nygma2004/Wifi_LokRemote/img/wired.jpg.jpg

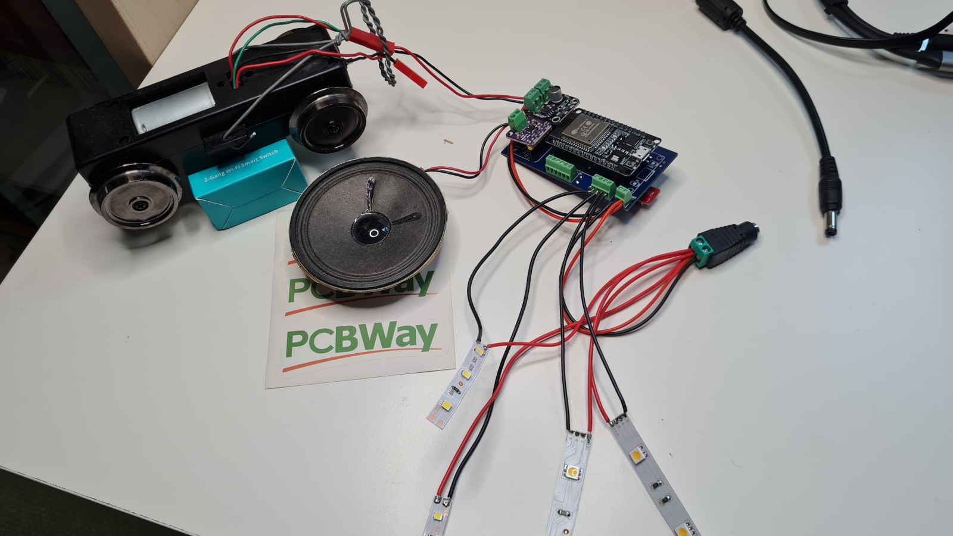
img/wired.jpg.jpg
