nygma2004/Wifi_LokRemote/img/with_phone_02.jpg

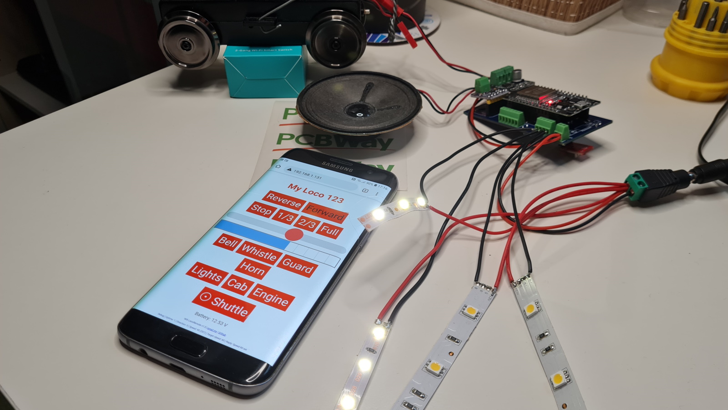
img/with_phone_02.jpg
