nygma2004/Wifi_LokRemote/pcb/Schematic_LocoRemote_v1_0.pdf

## PWM Motor Driver Board

## 5V power supply

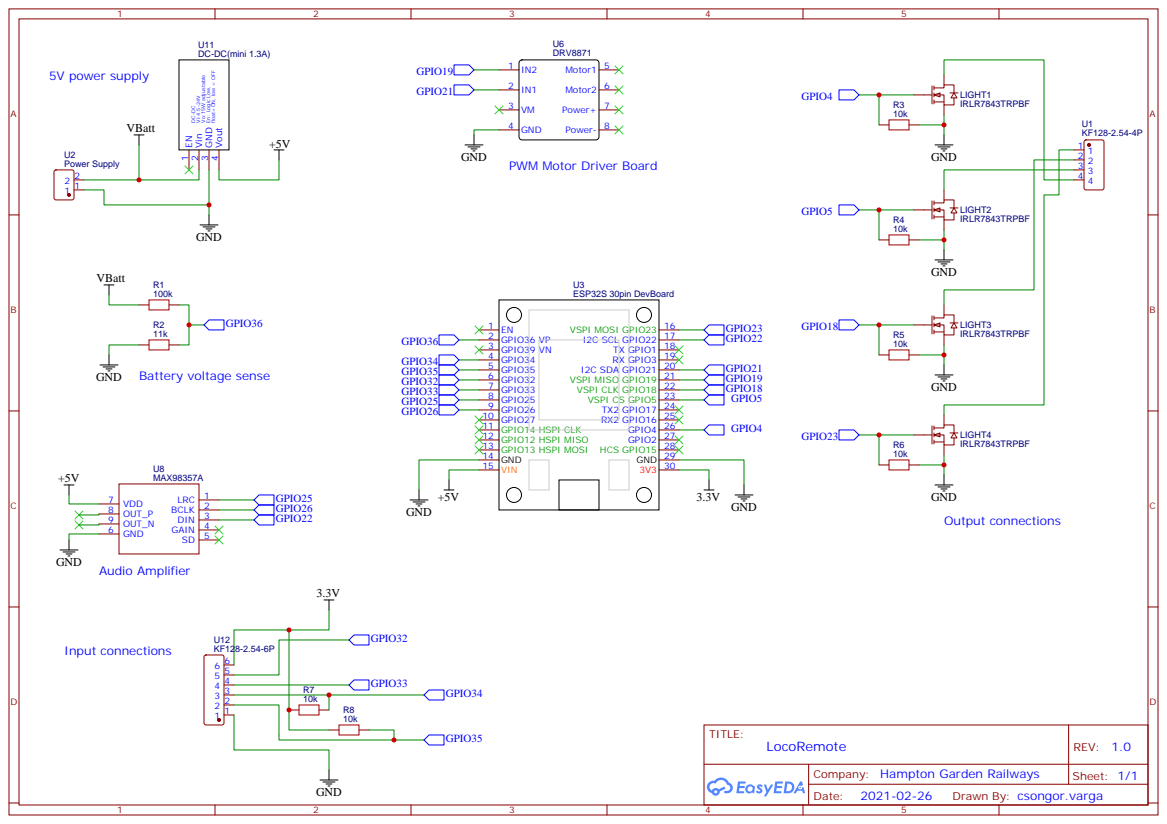
[picture p7: page 1]

float=ON, low = OFF

3V3 30 GND 29 HCS GPIO15 28 GPIO2 27 GPIO4 26 RX2 GPIO16 25 TX2 GPIO17 24 VSPI CS GPIO5 23 VSPI CLK GPIO18 22 VSPI MISO GPIO19 21 I2C SDA GPIO21 20 RX GPIO3 19 TX GPIO1 18 I2C SCL GPIO22 17 VSPI MOSI GPIO23 16

Company: Hampton Garden Railways

Drawn By: csongor.varga
